copperWhispers/Neighbour_Pleaser/IMG_20261023_104011353.jpg

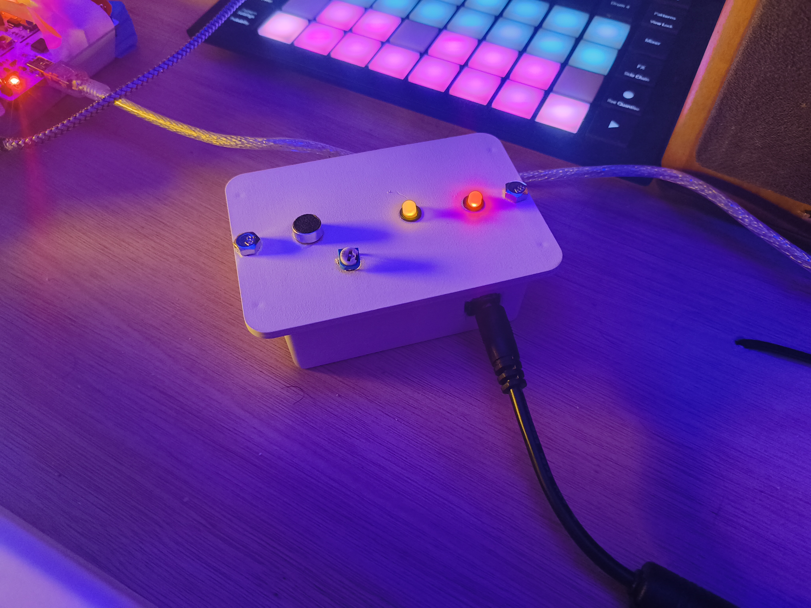
IMG_20261023_104011353.jpg
