copperWhispers/Neighbour_Pleaser/README.md

# Neighbour_Pleaser
A device that will please your neighborhood so that you don't make any life threatening enemies.
Also teaches how to convert Sound into voltage, precision rectifiers, opamps, comparators..
