copperWhispers/Neighbour_Pleaser/db_meter_75dB_v1.kicad_pcb

## KiCad design db_meter_75dB_v1.kicad_pcb (2026-10-24)

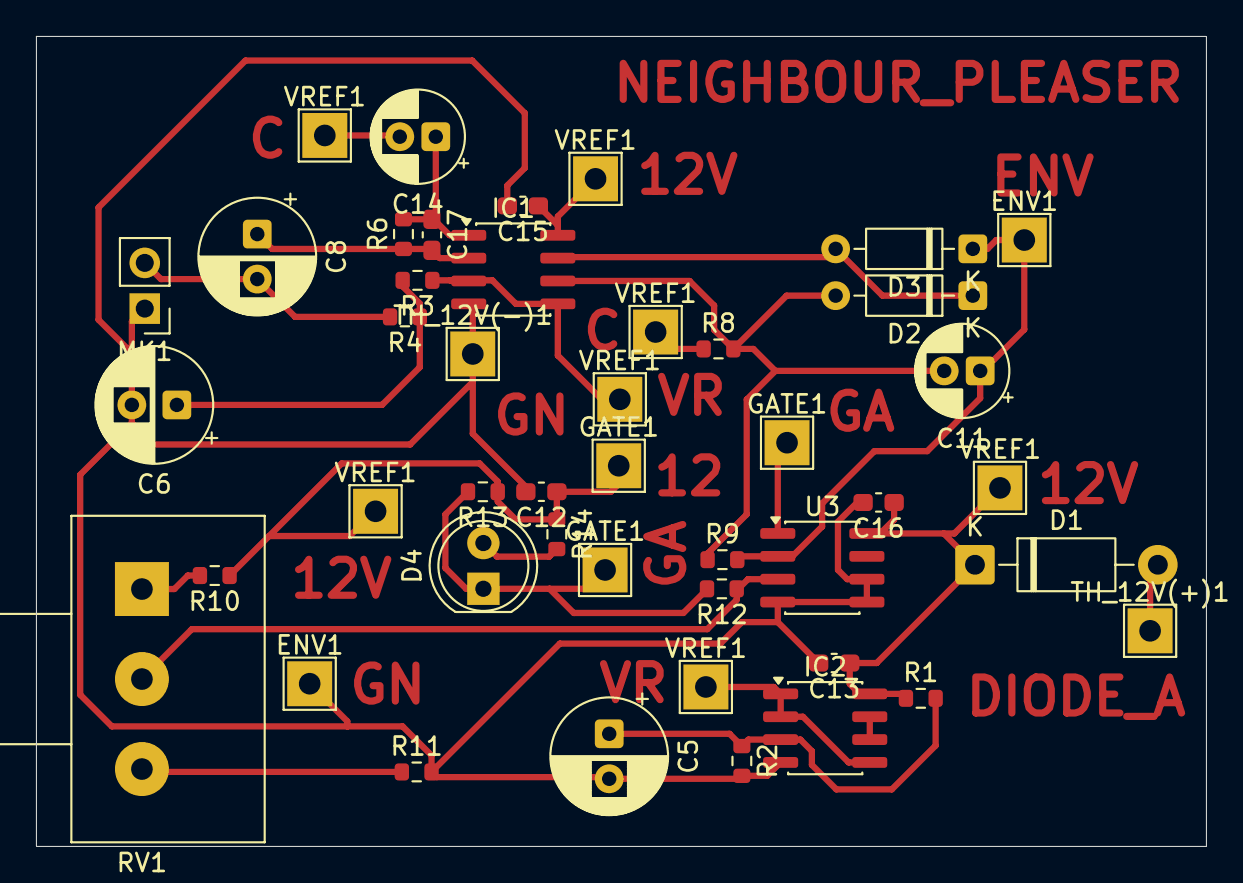
[picture p43: board db_meter_75dB_v1.kicad_pcb from above]

Board: 2 copper layers, 65.0 x 45.0 mm, 45 parts (0 on the bottom side), 19 nets.

Parts:
C5, C6: 100u; CP_Radial_D6.3mm_P2.50mm
C8: 10u; CP_Radial_D6.3mm_P2.50mm
C11: 4.7u; CP_Radial_D5.0mm_P2.00mm
C12, C13, C15: 100n; C_0603_1608Metric_Pad1.08x0.95mm_HandSolder
C14: 10u; CP_Radial_D5.0mm_P2.00mm
C16: 10u; C_0603_1608Metric_Pad1.08x0.95mm_HandSolder
C17: 47p; C_0603_1608Metric_Pad1.08x0.95mm_HandSolder
D1: 1N4001; D_DO-41_SOD81_P10.16mm_Horizontal
D2, D3: 1N4148; D_DO-35_SOD27_P7.62mm_Horizontal
D4: RED; LED_D5.0mm
ENV1, ENV1#2: TestPoint_THTPad_2.5x2.5mm_Drill1.2mm
GATE1, GATE1#2, GATE1#3: TestPoint_THTPad_2.5x2.5mm_Drill1.2mm
IC1, IC2: NE5532P; SOIC-8_3.9x4.9mm_P1.27mm
MK1: Electret; PinHeader_1x02_P2.54mm_Vertical
R1, R2, R13: 10k; R_0603_1608Metric
R3: 100; R_0603_1608Metric
R4: 2.2k; R_0603_1608Metric
R6, R9: 220k; R_0603_1608Metric
R8: 15k8; R_0603_1608Metric
R10: 7k5; R_0603_1608Metric
R11: 9k1; R_0603_1608Metric
R12: 1M; R_0603_1608Metric
R14: 4k7; R_0603_1608Metric
RV1: 1k trimmer; Potentiometer_Alps_RK163_Single_Horizontal
TH_12V(+)1, TH_12V(-)1: TestPoint_THTPad_2.5x2.5mm_Drill1.2mm
U3: LM393D; SOIC-8_3.9x4.9mm_P1.27mm
VREF1, VREF1#2, VREF1#3, VREF1#4, VREF1#5, VREF1#6, VREF1#7: TestPoint_THTPad_2.5x2.5mm_Drill1.2mm

Connections:
+12V: C12.1, C13.1, C15.1, C16.1, D1.1 (K), GATE1.1, IC1.8 (VCC+), IC2.8 (VCC+), R1.1, R10.1, R13.1, R14.1, U3.8 (VCC+), VREF1.1, VREF1#6.1, VREF1#7.1
/ENV: C11.1, D3.1 (K), ENV1.1, R9.2, U3.2 (IN1-)
/GATE: D4.1 (K), GATE1#2.1, GATE1#3.1, R12.2, R13.2, U3.1 (OUT1)
/OUT_AMP2: D2.1 (K), D3.2 (A), IC1.7 (2OUT)
/VREF: IC1.3 (1IN+), IC1.5 (2IN+), IC2.1 (1OUT), IC2.2 (1IN-), IC2.5 (2IN+), R3.1, VREF1#2.1, VREF1#3.1
/Vtrigger: R12.1, RV1.2, U3.3 (IN1+)
GND: C5.2, C6.2, C12.2, C13.2, C15.2, C16.2, ENV1#2.1, IC1.4 (VCC-), IC2.4 (VCC-), MK1.1 (-), R2.2, R11.2, TH_12V(-)1.1, U3.4 (VCC-), U3.5 (IN2+), U3.6 (IN2-)
unnamed: C6.1, R3.2, R4.1
unnamed: C14.2, R8.1, VREF1#4.1, VREF1#5.1
unnamed: D1.2 (A), TH_12V(+)1.1
unnamed: C11.2, D2.2 (A), IC1.6 (2IN-), R8.2, R9.1
unnamed: D4.2 (A), R14.2
unnamed: C8.1, C17.2, IC1.2 (1IN-), R6.1
unnamed: C14.1, C17.1, IC1.1 (1OUT), R6.2
unnamed: C5.1, IC2.3 (1IN+), R1.2, R2.1
unnamed: IC2.6 (2IN-), IC2.7 (2OUT)
unnamed: C8.2, MK1.2 (+), R4.2
unnamed: R10.2, RV1.1
unnamed: R11.1, RV1.3
